MrPkz/TP2-FMController/README.md

# TP2-FMController
Trabajo realizado para la asignatura "Taller de Proyecto 2" de la carrera de ingeniería en computación, en la Facultad de Informática de la Universidad Nacional de La Plata.

Autores: Ramiro Madera y Ulises Pereira. 

Profesor a cargo: Fernando Tinetti.

Detalles y especificaciones sobre el trabajo se encuentran en el archivo "F5-InformeFinalTP2".
